dlip/harite-v2/kicad/thumbstick-breakout/README.md

Adapted from https://github.com/dbenoy/thumbstick-breakout to include a FPC connector
