dlip/harite-v2/harite-v2-bom.ods

Ordered | Name | Qty | Notes
Yes | Left PCB | 1 | Order using files in kicad/left/gerber_to_order
Yes | Right PCB | 1 | Order using files in kicad/right/gerber_to_order
Yes | Thumb cluster PCB | 2 | Order using files in kicad/thumb-cluster/gerber_to_order
Yes | Thumbstick Breakout PCB | 0-2 | Order using files in kicad/thumbstick-breakout/gerber_to_order
Yes | PMW3389 Motion Sensor | 0-2 | https://www.tindie.com/products/citizenjoe/pmw3389-motion-sensor/
y | 1/4-20 8mm OD 6mm height Knurled Insert Nut | 2 | For camera mounts https://www.aliexpress.com/item/1005005225137961.html
Yes | Smallrig clamp and ball mount | 2 | https://www.amazon.com.au/SmallRig-Ballhead-Multi-Function-Adapter-Ronin-M/dp/B08C2W7SK6/
Yes | M3 knurled insert nuts 6mm length 4.2 OD | 2 | For thumb cluster mount
y | m3*6 screws | 2 | For thumb cluster mount
y | M2 knurled insert nuts 3mm length 3.5mm OD | 36 | 24 for cases and 12 for switch caps https://www.aliexpress.com/item/1005003582355741.html
y | M2*5 screw | 12 | for switch caps
y | M2*5 screw | 8 | for base pcb
y | M2*6 screw | 16 | for thumb cluster cases
 | trackball screw?
y | 1N4148 SOD-123 Diodes | 60
y | 5 pin FFC connector Amphenol IIC 59453-051110ECHLF | 0-2 | For joystick https://www.digikey.com.au/en/products/detail/amphenol-cs-fci/59453-051110ECHLF/4272135
y | 5 pin FFC cable type-A 0.5 pitch 10cm length | 0-2 | For joystick https://www.aliexpress.com/item/1005006274471212.html
y | 8 pin FFC connector Amphenol IIC 59453-081110EDHLF | 2 | For thumb cluster https://www.digikey.com.au/en/products/detail/amphenol-cs-fci/59453-081110EDHLF/4272146
y | 8 pin FFC cable type-A 0.5 pitch 10cm length | 2 | For Thumb cluster https://www.aliexpress.com/item/1005006274471212.html
y | 12 pin FFC connector Amphenol IIC 59453-121110ECHLF | 0-2 | For Cirque Trackpad https://www.digikey.com.au/en/products/detail/amphenol-cs-fci/59453-121110ECHLF/4272151
y | 12 pin FFC cable type-A 0.5 pitch 10cm length | 0-2 | For Cirque trackpad https://www.aliexpress.com/item/1005006274471212.html
y | RP2040-Zero controller with headers 2.5mm height | 2
y | Cirque 40mm Trackpads TM040040-2024-302 flat overlay | 0-2
y | SKRHADE010 5-way switches | 12 | https://www.aliexpress.com/item/1005008022179292.html
y | ps5 hall effect joystick | 0-2 | https://www.aliexpress.com/item/1005006282848536.html
y | HRO TYPE-C-31-M-12 USB C female ports
y | USB-C to USB-C cable | 1 | To connect halves
y | USB-C to USB-A/C cable | 1 | To connect to pc
y | Super glue and toothpicks for joystick stems | 1
y | X-Ring of thickness 1.78mm and inner diameter 6.75mm | 12 | https://www.aliexpress.com/item/1005006039394059.html
y | 34mm trackball | 0-2 | https://www.amazon.com.au/Perixx-PERIPRO-303GR-Trackball-Glossy-Compatible/dp/B071NX7Y2J?th=1
y | 3mm Si3N4 static bearings | 3 per trackball | https://www.aliexpress.com/item/1005007489758993.htm
y | BTU bearings (Veichu VCN310, 7.5mm) | 3 per trackball | https://www.aliexpress.com/item/1005003066404497.html
