dlip/harite-v2/freecad/thumbstick.FCStd

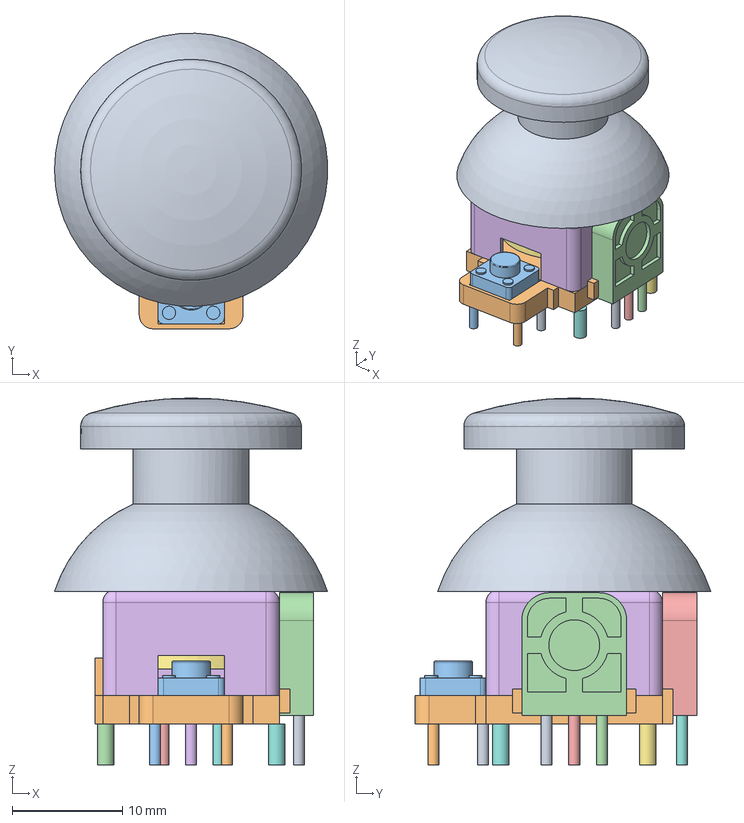
[picture p1: CAD file, 2025-01-04]
freecad/thumbstick.FCStd
24.7 x 26.8 x 33.2 mm
Thumbstick
