dlip/harite-v2/freecad/thumb-mount.FCStd

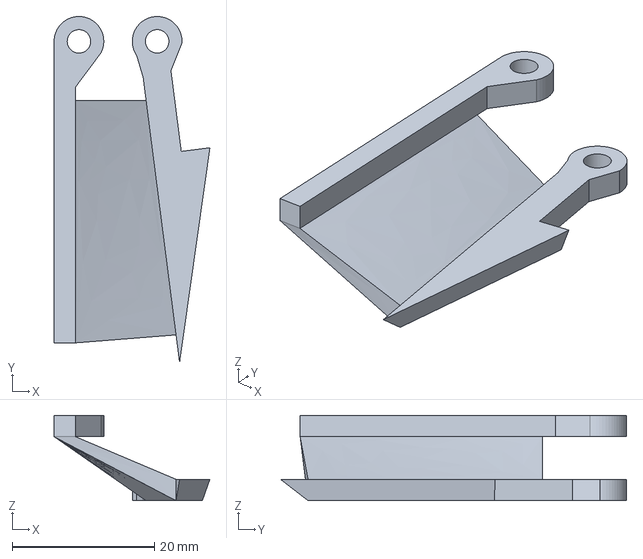
[picture p2: CAD file, 2025-01-04]
freecad/thumb-mount.FCStd
21.9 x 48.7 x 12.0 mm
