dlip/harite-v2/freecad/thumbstick-breakout.FCStd

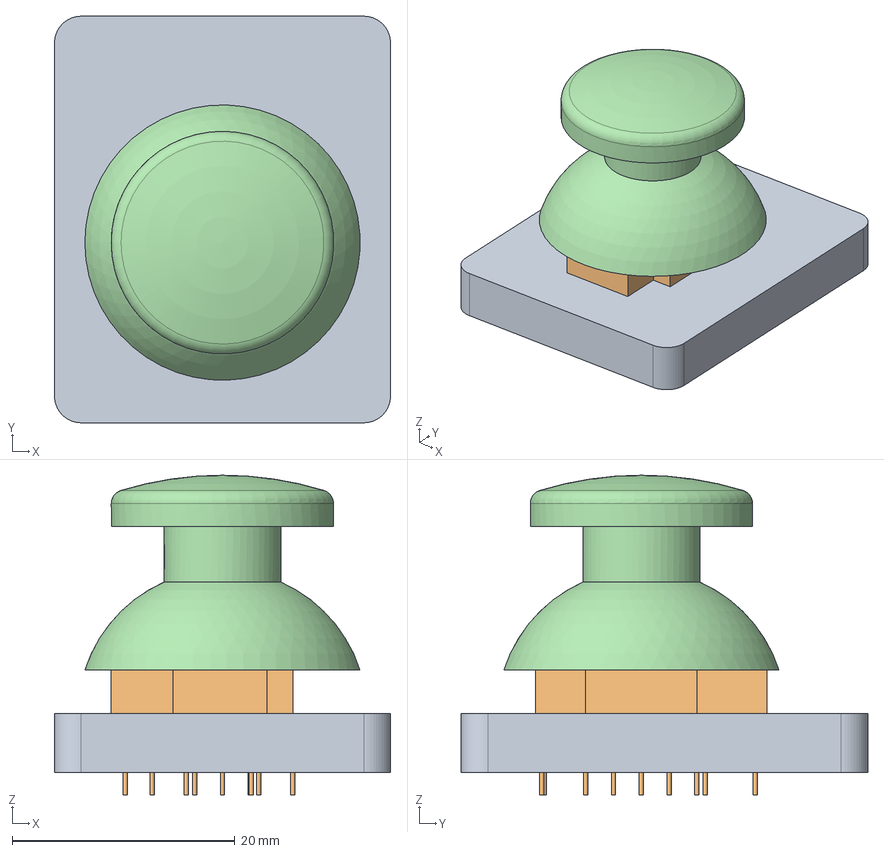
[picture p3: CAD file, 2025-01-03]
freecad/thumbstick-breakout.FCStd
30.2 x 36.5 x 28.7 mm
top
stick
Thumbstick
