dlip/harite-v2/freecad/thumbstick-breakout-orig.FCStd

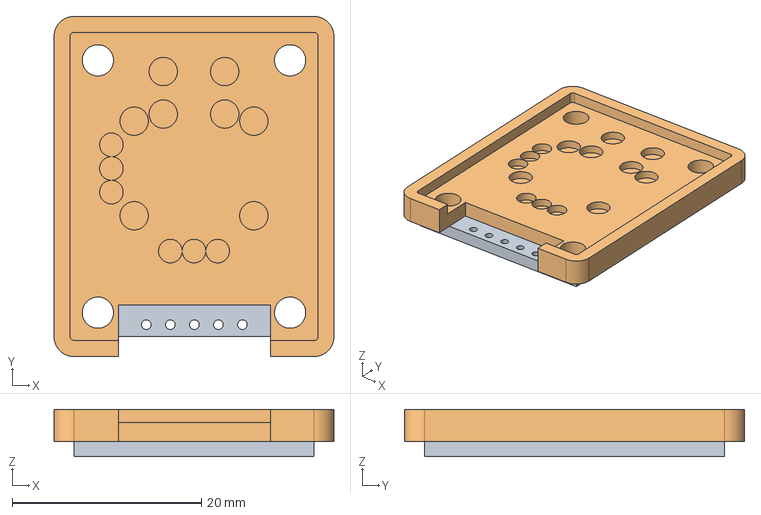
[picture p4: CAD file, 2024-12-31]
freecad/thumbstick-breakout-orig.FCStd
29.6 x 35.9 x 5.00 mm
Pcb_bbd4
base
