dlip/harite-v2/freecad/caps.FCStd

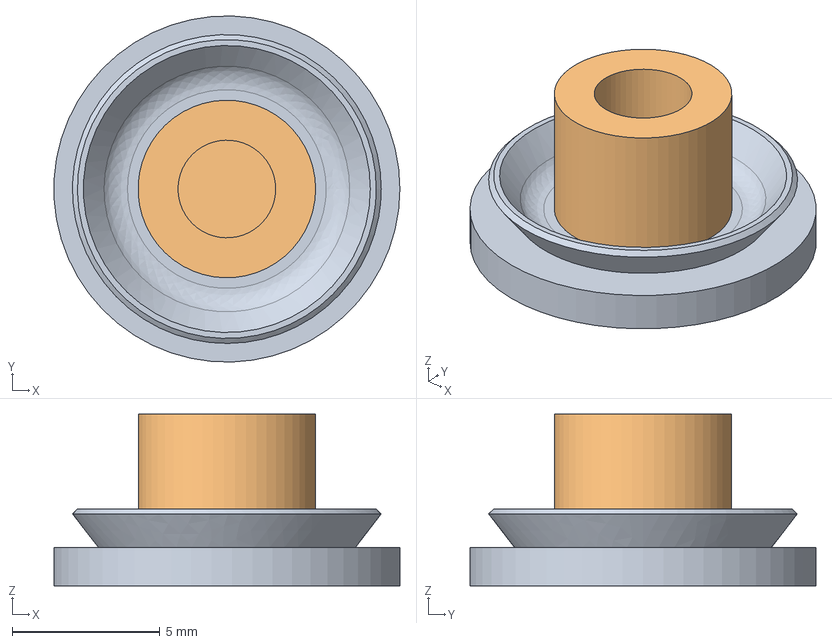
[picture p5: CAD file, 2024-12-24]
freecad/caps.FCStd
11.7 x 11.7 x 5.80 mm
xring
stem
