dlip/harite-v2/freecad/thumb-cluster.FCStd

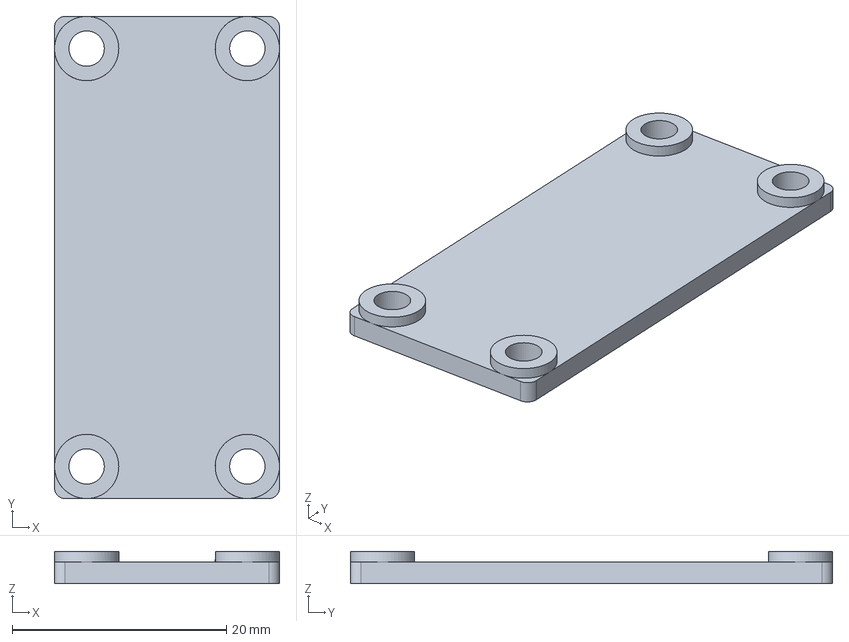
[picture p6: CAD file, 2024-12-23]
freecad/thumb-cluster.FCStd
21.0 x 45.0 x 3.00 mm
