dlip/harite-v2/freecad/case-vertical.FCStd

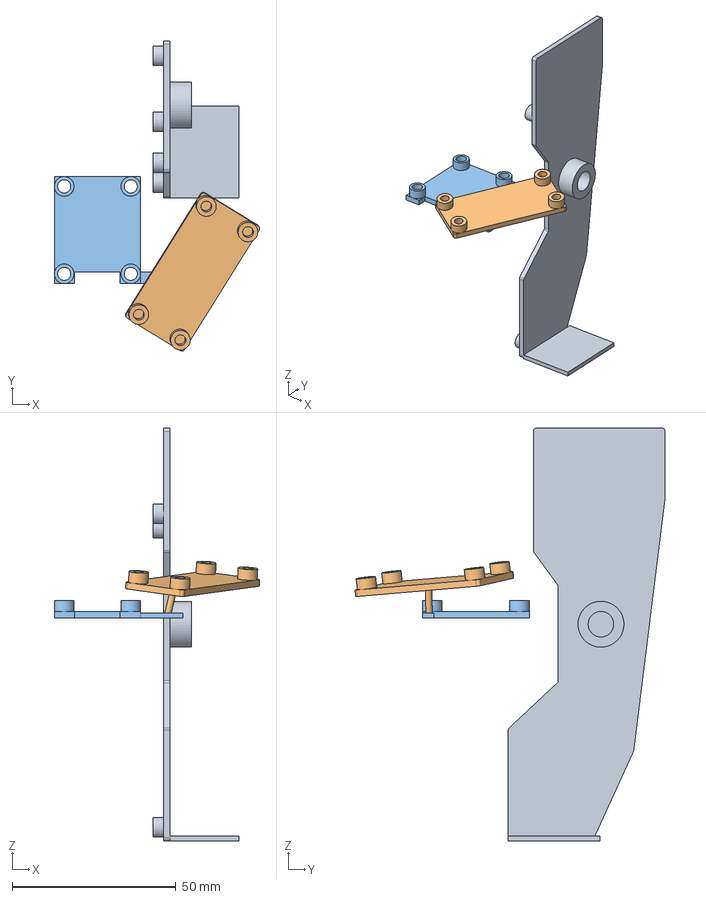
[picture p7: CAD file, 2024-12-21]
freecad/case-vertical.FCStd
62.6 x 94.6 x 126.0 mm
Left
Thumb
Thumbstick
