dlip/harite-v2/freecad/case-tented.FCStd

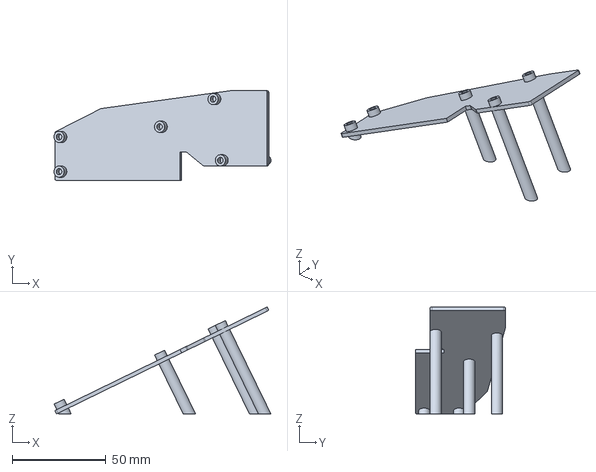
[picture p8: CAD file, 2024-12-20]
freecad/case-tented.FCStd
115.7 x 47.9 x 57.0 mm
