dlip/harite-v2/freecad/trackball-holder.FCStd

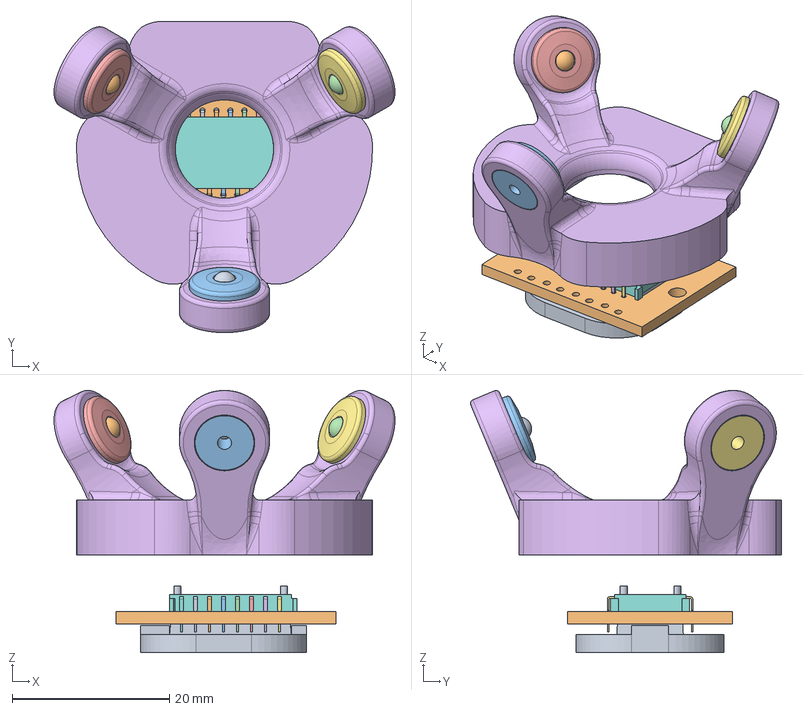
[picture p9: CAD file, 2024-12-19]
freecad/trackball-holder.FCStd
43.4 x 39.6 x 33.4 mm
Static bearing
Static bearing001
Bearing holder
Static bearing002
Bearing holder001
Trackball-holder
Bearing holder002
Lead
Lead001
Lead002
Lead003
Lead004
Lead005
Lead006
Lead007
Lead(Mirror)
Lead(Mirror)001
Lead(Mirror)002
Lead(Mirror)003
Lead(Mirror)004
Lead(Mirror)005
Lead(Mirror)006
Lead(Mirror)007
Lens
PMW3360DM PCB
