dlip/harite-v2/freecad/tindie-pmw3360.FCStd

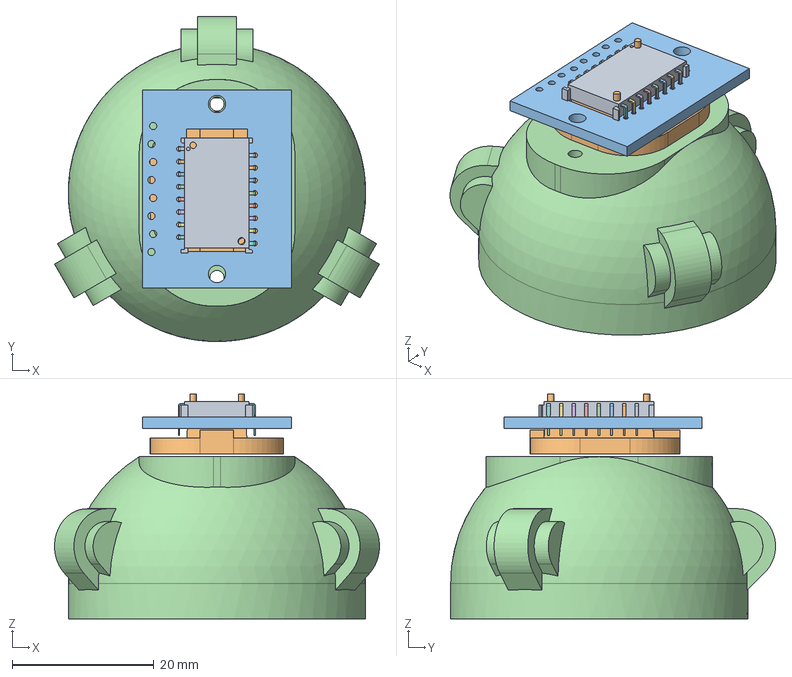
[picture p10: CAD file, 2024-12-19]
freecad/tindie-pmw3360.FCStd
45.9 x 45.9 x 31.7 mm
Lead008
Lead009
Lead010
Lead011
Lead012
Lead013
Lead014
Lead015
Lead(Mirror)008
Lead(Mirror)009
Lead(Mirror)010
Lead(Mirror)011
Lead(Mirror)012
Lead(Mirror)013
Lead(Mirror)014
Lead(Mirror)015
Lens001
PMW3360DM PCB001
Trackball_Holder
