dlip/harite-v2/freecad/case-tent.FCStd

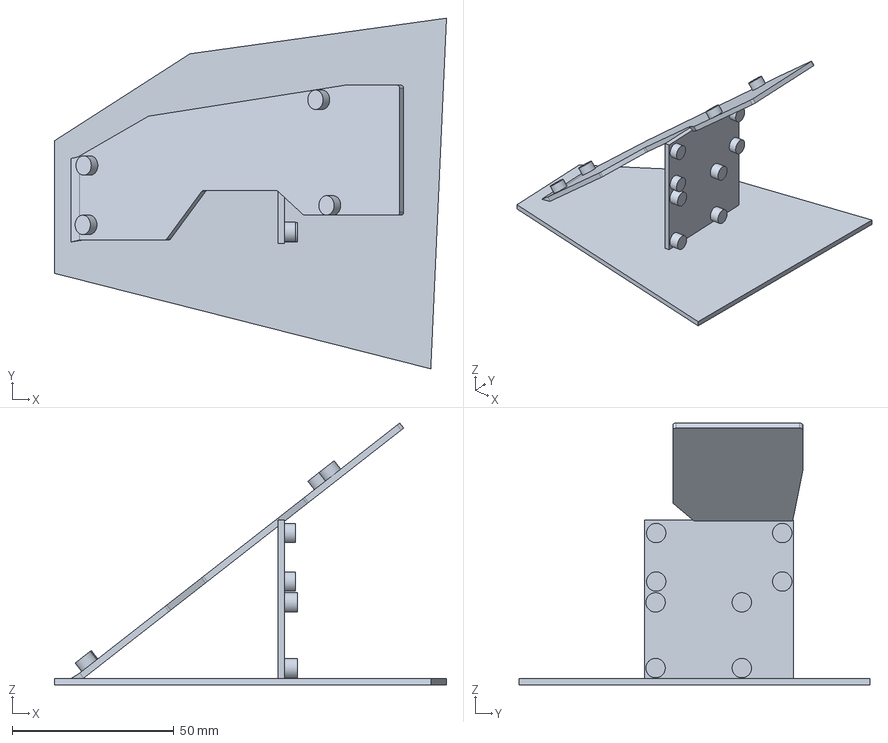
[picture p11: CAD file, 2024-12-14]
freecad/case-tent.FCStd
121.3 x 108.5 x 81.0 mm
