dlip/harite-v2/freecad/case-tent-nojoy.FCStd

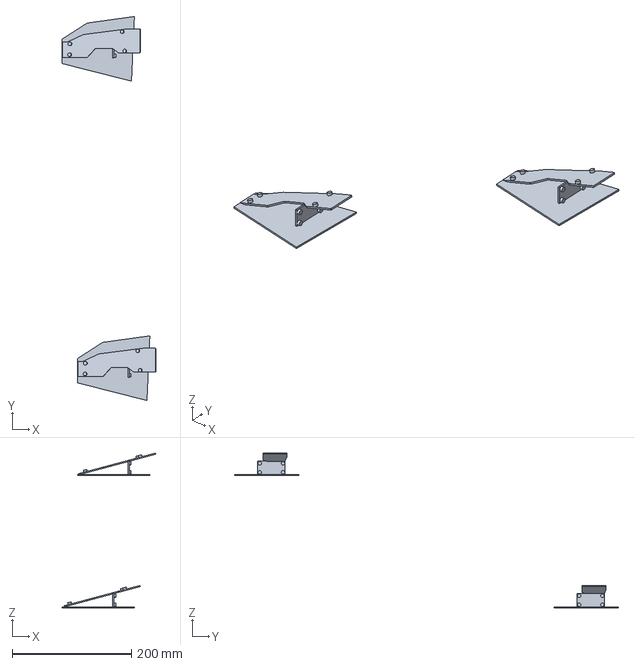
[picture p12: CAD file, 2024-12-14]
freecad/case-tent-nojoy.FCStd
157.2 x 644.2 x 259.9 mm
