dlip/harite-v2/freecad/case.FCStd

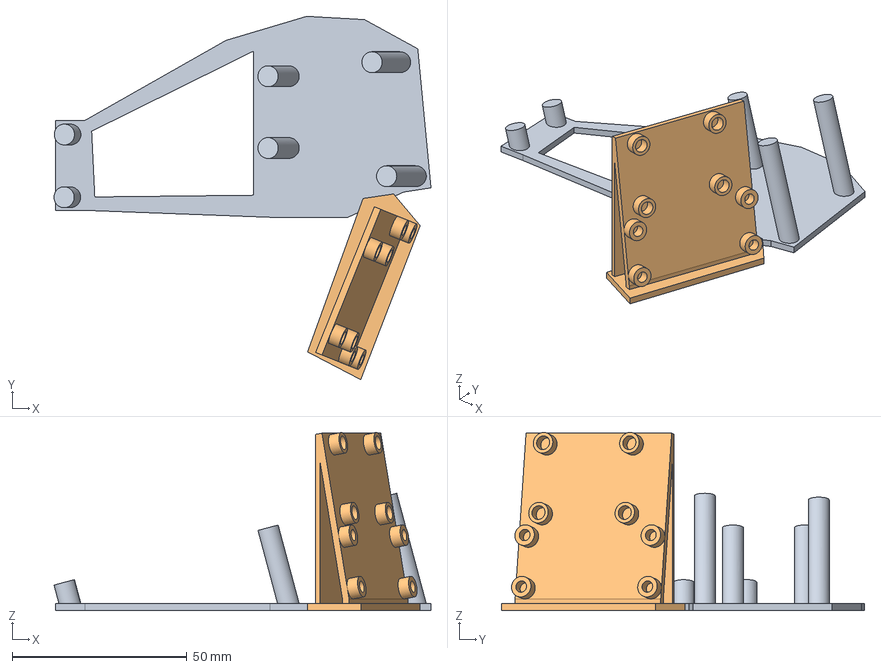
[picture p13: CAD file, 2024-12-12]
freecad/case.FCStd
108.0 x 104.1 x 51.0 mm
