dlip/harite-v2/(list of files, cad)

Other CAD files:
freecad/assemblies.FCStd
