dlip/harite-v2/kicad/left/left.kicad_pcb

## KiCad design kicad/left/left.kicad_pcb (2024-12-19)

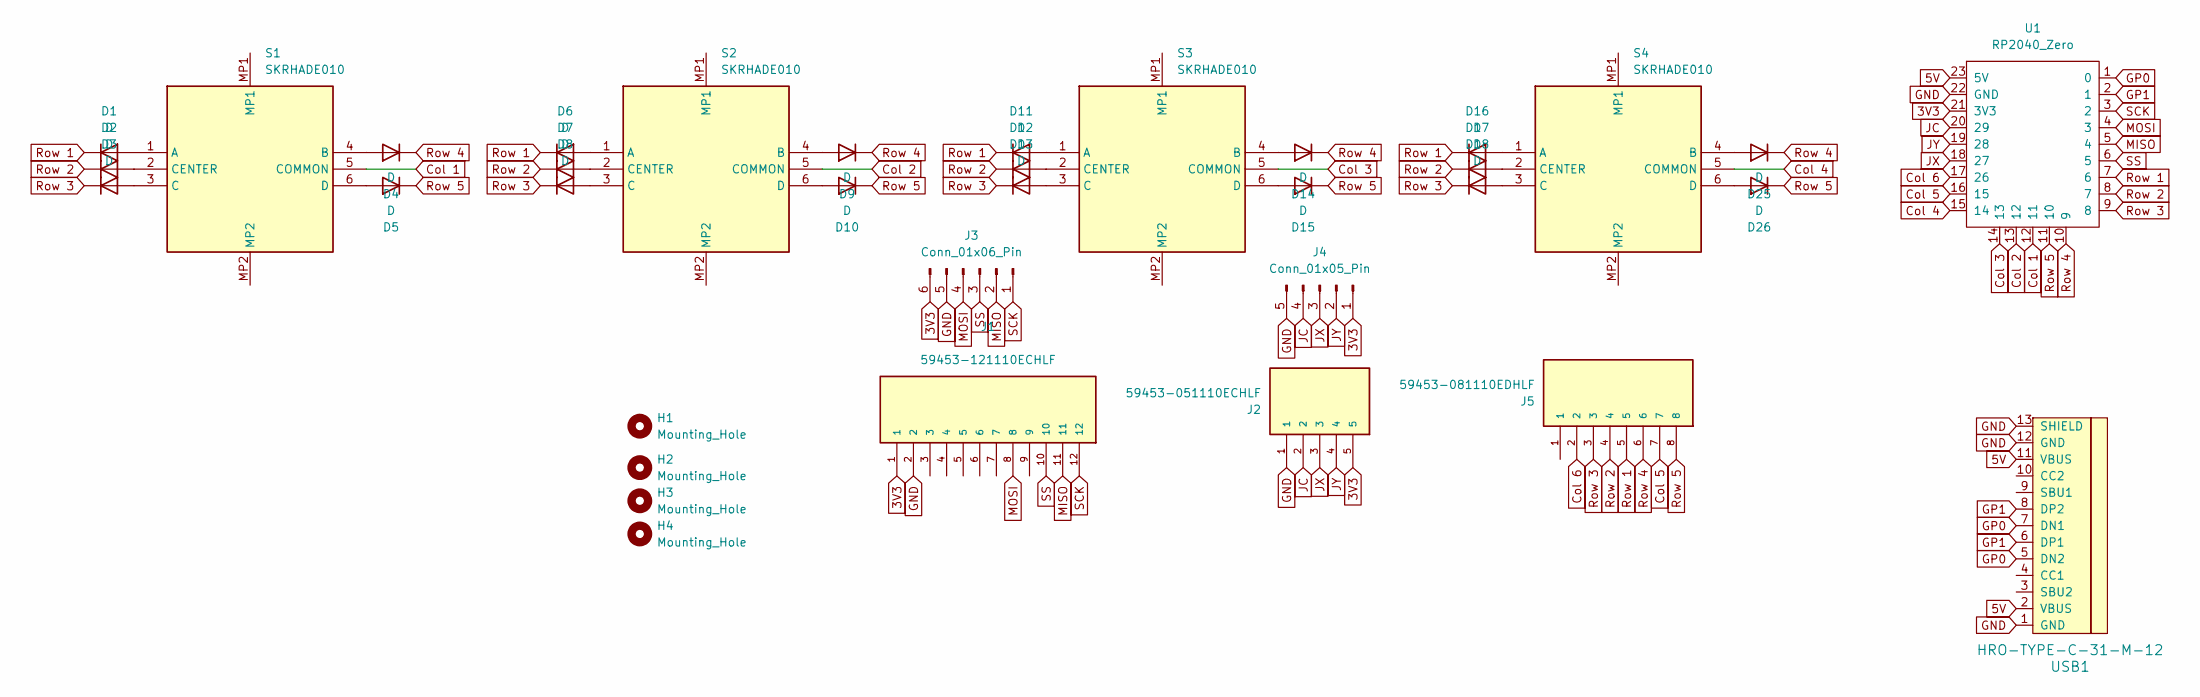
[picture p14: schematic left.kicad_sch]

Parts:
D1, D2, D3, D4, D5, D6, D7, D8, D9, D10, D11, D12, D13, D14, D15, D16, D17, D18, D25, D26: D; Diode_SOD-123
H1, H2, H3, H4: Mounting_Hole; MountingHole_2.2mm_M2_Pad_Via
J1: 59453-121110ECHLF; AMPHENOL_59453-121110ECHLF; PARTREV A
J2: 59453-051110ECHLF; AMPHENOL_59453-051110ECHLF; PARTREV A
J3: Conn_01x06_Pin; Pointing-connector
J4: Conn_01x05_Pin; Joystick-connector
J5: 59453-081110EDHLF; AMPHENOL_59453-081110EDHLF; PARTREV D
S1, S2, S3, S4: SKRHADE010; Manufacturer_Part_Number SKRHADE010; Mouser Part Number 688-SKRHAD
U1: RP2040_Zero
USB1: HRO-TYPE-C-31-M-12

Connections:
3V3: J1.1, J2.5, J3.6, J4.1, U1.21 (3V3)
5V: U1.23 (5V), USB1.2 (VBUS), USB1.11 (VBUS)
Col 1: S1.5 (COMMON), U1.12 (11)
Col 2: S2.5 (COMMON), U1.13 (12)
Col 3: S3.5 (COMMON), U1.14 (13)
Col 4: S4.5 (COMMON), U1.15 (14)
Col 5: J5.7, U1.16 (15)
Col 6: J5.2, U1.17 (26)
GND: J1.2, J2.1, J3.5, J4.5, U1.22 (GND), USB1.1 (GND), USB1.12 (GND), USB1.13 (SHIELD)
GP0: U1.1 (0), USB1.5 (DN2), USB1.7 (DN1)
GP1: U1.2 (1), USB1.6 (DP1), USB1.8 (DP2)
JC: J2.2, J4.4, U1.20 (29)
JX: J2.3, J4.3, U1.18 (27)
JY: J2.4, J4.2, U1.19 (28)
MISO: J1.11, J3.2, U1.5 (4)
MOSI: J1.8, J3.4, U1.4 (3)
unnamed: D1.2 (A), S1.1 (A)
unnamed: D2.2 (A), S1.2 (CENTER)
unnamed: D3.2 (A), S1.3 (C)
unnamed: D4.2 (A), S1.4 (B)
unnamed: D5.2 (A), S1.6 (D)
unnamed: D6.2 (A), S2.1 (A)
unnamed: D7.2 (A), S2.2 (CENTER)
unnamed: D8.2 (A), S2.3 (C)
unnamed: D9.2 (A), S2.4 (B)
unnamed: D10.2 (A), S2.6 (D)
unnamed: D11.2 (A), S3.1 (A)
unnamed: D12.2 (A), S3.2 (CENTER)
unnamed: D13.2 (A), S3.3 (C)
unnamed: D14.2 (A), S3.4 (B)
unnamed: D15.2 (A), S3.6 (D)
unnamed: D16.2 (A), S4.1 (A)
unnamed: D17.2 (A), S4.2 (CENTER)
unnamed: D18.2 (A), S4.3 (C)
unnamed: D25.2 (A), S4.4 (B)
unnamed: D26.2 (A), S4.6 (D)
Row 1: D1.1 (K), D6.1 (K), D11.1 (K), D16.1 (K), J5.5, U1.7 (6)
Row 2: D2.1 (K), D7.1 (K), D12.1 (K), D17.1 (K), J5.4, U1.8 (7)
Row 3: D3.1 (K), D8.1 (K), D13.1 (K), D18.1 (K), J5.3, U1.9 (8)
Row 4: D4.1 (K), D9.1 (K), D14.1 (K), D25.1 (K), J5.6, U1.10 (9)
Row 5: D5.1 (K), D10.1 (K), D15.1 (K), D26.1 (K), J5.8, U1.11 (10)
SCK: J1.12, J3.1, U1.3 (2)
SS: J1.10, J3.3, U1.6 (5)

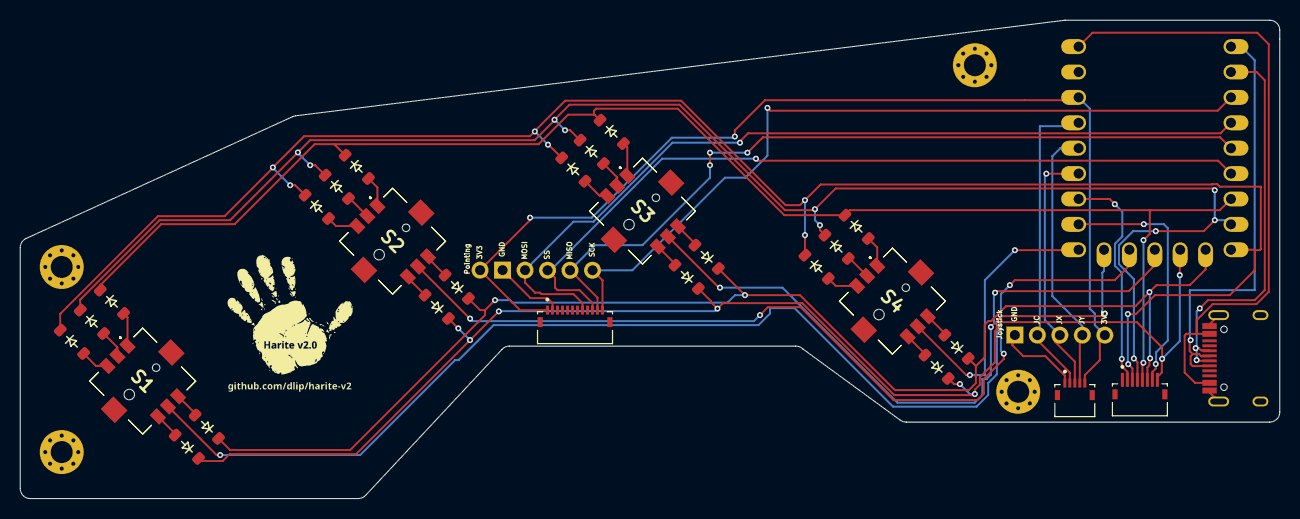
[picture p15: board left.kicad_pcb from above]

Board: 2 copper layers, 126.0 x 47.8 mm, 35 parts (0 on the bottom side), 43 nets.
