dlip/harite-v2/kicad/thumbstick-breakout/thumbstick-breakout.kicad_pcb

## KiCad design kicad/thumbstick-breakout/thumbstick-breakout.kicad_pcb (2024-12-18)

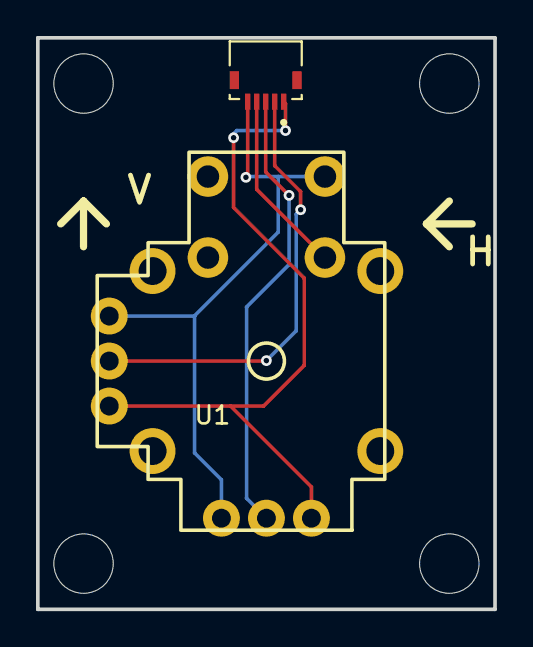
[picture p16: board thumbstick-breakout.kicad_pcb from above]

Board: 2 copper layers, 25.4 x 31.8 mm, 6 parts (0 on the bottom side), 5 nets.

Parts:
J1: 59453-051110ECHLF; AMPHENOL_59453-051110ECHLF
U1: Joystick
U$3, U$4, U$5, U$6: Screw Hole

Connections:
/HORZ: J1.3, U1.2 (H)
/SEL: J1.4, U1.a (SEL+)
/VERT: J1.2, U1.2' (V)
GND: J1.5, U1.1 (H-), U1.1' (V-), U1.c (SEL-)
VCC: J1.1, U1.3 (H+), U1.3' (V+)
