dlip/harite-v2/kicad/thumb-cluster/thumb-cluster.kicad_pcb

## KiCad design kicad/thumb-cluster/thumb-cluster.kicad_pcb (2024-12-12)

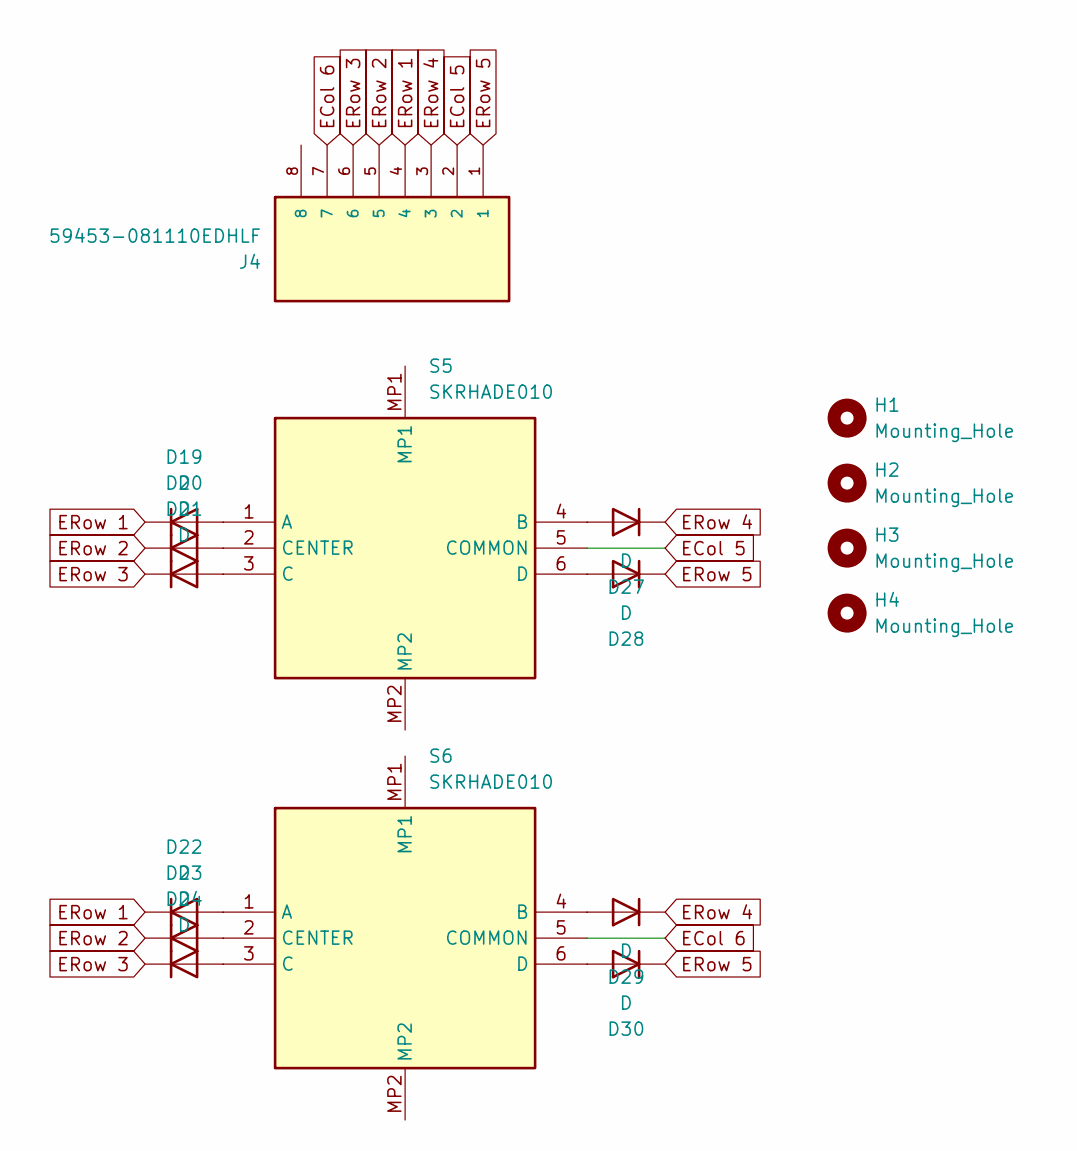
[picture p17: schematic thumb-cluster.kicad_sch]

Parts:
D19, D20, D21, D22, D23, D24, D27, D28, D29, D30: D; Diode_SOD-123
H1, H2, H3, H4: Mounting_Hole; MountingHole_2.2mm_M2_Pad_Via
J4: 59453-081110EDHLF; AMPHENOL_59453-081110EDHLF; PARTREV D
S5, S6: SKRHADE010; Manufacturer_Part_Number SKRHADE010; Mouser Part Number 688-SKRHAD

Connections:
ECol 5: J4.2, S5.5 (COMMON)
ECol 6: J4.7, S6.5 (COMMON)
ERow 1: D19.1 (K), D22.1 (K), J4.4
ERow 2: D20.1 (K), D23.1 (K), J4.5
ERow 3: D21.1 (K), D24.1 (K), J4.6
ERow 4: D27.1 (K), D29.1 (K), J4.3
ERow 5: D28.1 (K), D30.1 (K), J4.1
unnamed: D19.2 (A), S5.1 (A)
unnamed: D20.2 (A), S5.2 (CENTER)
unnamed: D21.2 (A), S5.3 (C)
unnamed: D22.2 (A), S6.1 (A)
unnamed: D23.2 (A), S6.2 (CENTER)
unnamed: D24.2 (A), S6.3 (C)
unnamed: D27.2 (A), S5.4 (B)
unnamed: D28.2 (A), S5.6 (D)
unnamed: D29.2 (A), S6.4 (B)
unnamed: D30.2 (A), S6.6 (D)

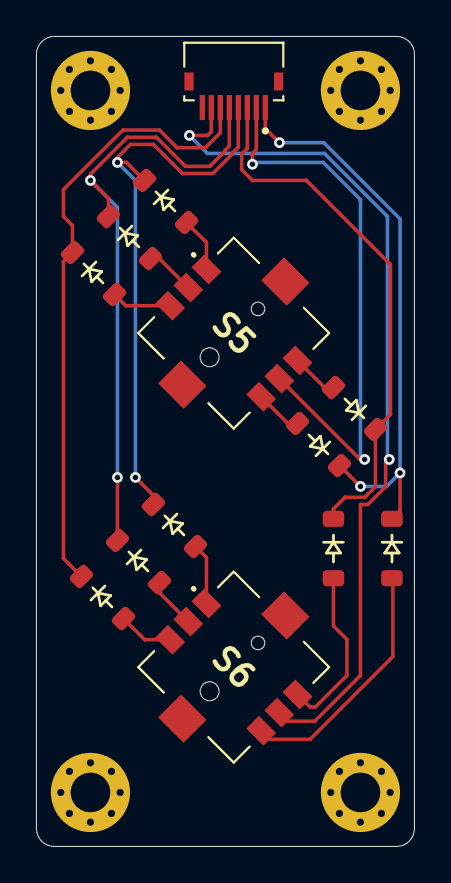
[picture p18: board thumb-cluster.kicad_pcb from above]

Board: 2 copper layers, 21.0 x 45.0 mm, 17 parts (0 on the bottom side), 17 nets.
