dlip/harite-v2/(threads)

Thread 1 (2025-01-12):

Righcasetop

RudolfVonKrugstein, 2025-01-12:
This file (https://github.com/dlip/harite-v2/blob/main/freecad/right-casetop.stl) is missing, is it not?

Thanks for the great project by the way.

dlip, 2025-01-12:
@RudolfVonKrugstein Nice catch, thanks

Closed 2025-01-12.
