dlip/harite-v2/(commit log)

2024-11-28 Add project
    [harite.kicad_sch]
2024-11-28 move kicad
    [harite.kicad_sch]
2024-12-04 break up parts
    [harite.kicad_pcb, joystick.kicad_pcb, joystick.kicad_sch, left.kicad_pcb, left.kicad_sch, thumb-cluster.kicad_pcb, thumb-cluster.kicad_sch]
2024-12-05 Freecad xring
    [cap-xring-Body.stl, cap-xring.FCStd]
2024-12-06 Freecad pcb
    [cap-xring.FCStd, harite-brd.dxf, harite-cap-xring.stl, harite.FCStd, left-brd.dxf, left.kicad_pcb, thumb-cluster-brd.dxf, thumbstick-brd.dxf]
2024-12-08 Create base
    [harite.FCStd]
2024-12-08 Add thumb cluster
    [harite.FCStd, thumb-cluster.FCStd, thumb-cluster.kicad_pcb]
2024-12-11 Add connectors
    [left.kicad_pcb, left.kicad_sch]
2024-12-11 Rename caps
    [caps.FCStd]
2024-12-11 Update footprints
    [left.kicad_pcb, left.kicad_sch]
2024-12-11 reimport files
    [caps-xring.stl, case.FCStd, harite-cap-xring.stl, harite.FCStd, left.kicad_pcb, thumb-cluster.FCStd, thumb-cluster.kicad_pcb]
2024-12-11 Add joystick breakout
    [left.kicad_pcb, left.kicad_sch, thumbstick-breakout.kicad_pcb, thumbstick-breakout.kicad_sch, thumbstick.kicad_pcb]
2024-12-11 update freecad
    [left.kicad_pcb, thumbstick-breakout.FCStd, thumbstick-breakout.kicad_pcb]
2024-12-12 extend breakout
    [thumbstick-breakout.FCStd, thumbstick-breakout.kicad_pcb]
2024-12-12 Add stem
    [cap-xring-Body.stl, caps.FCStd]
2024-12-12 Add tent
    [assemblies.FCStd, case-Part.stl, case.FCStd, thumbstick-breakout.FCStd]
2024-12-12 update thumb cluster
    [thumb-cluster.FCStd, thumb-cluster.kicad_pcb, thumb-cluster.kicad_sch]
2024-12-14 Add holes
    [case-tent-PartBody.stl, case-tent-nojoy.FCStd, case-tent.FCStd, left.kicad_pcb, left.kicad_sch]
2024-12-14 Add vertical case
    [caps.FCStd, case-vertical.FCStd, thumbstick-breakout.FCStd]
2024-12-15 thumb pos
    [caps.FCStd, case-vertical.FCStd, thumbstick-breakout.FCStd, thumbstick.FCStd]
2024-12-15 thumb 2
    [case-vertical.FCStd]
2024-12-15 trackball holder
    [case-vertical.FCStd, trackball-holder.FCStd]
2024-12-16 thumb 3
    [case-vertical.FCStd, trackball-holder.FCStd]
2024-12-18 Use only fcc on thumbstick
    [thumbstick-breakout.kicad_pcb, thumbstick-breakout.kicad_sch]
2024-12-18 Update thumbstick
    [case-vertical.FCStd, thumbstick-breakout.FCStd]
2024-12-18 Add right
    [right.kicad_pcb, right.kicad_sch]
2024-12-18 place right components
    [right.kicad_pcb]
2024-12-18 wire right
    [right.kicad_pcb]
2024-12-19 Add gerbers
    [left.kicad_pcb, right.kicad_pcb]
2024-12-19 Add tindie
    [case-vertical.FCStd, tindie-pmw3360.FCStd]
2024-12-19 Add bom and camera mount
    [case-vertical.FCStd, harite-v2-bom.ods, thumbstick.FCStd, tindie-pmw3360.FCStd, trackball-holder.FCStd]
2024-12-19 Another case
    [caps.FCStd, case-tented.FCStd, case-vertical.FCStd, harite-v2-bom.ods, thumbstick-breakout.FCStd, thumbstick.FCStd, tindie-pmw3360.FCStd, trackball-holder.FCStd]
2024-12-20 simple case
    [case-simple.FCStd, case-tented.FCStd]
2024-12-20 Base with top
    [assemblies.FCStd, caps.FCStd, case-simple.FCStd, case-tented.FCStd, case-vertical.FCStd, thumb-cluster.FCStd, thumbstick-breakout.FCStd]
2024-12-21 top and bottom
    [assemblies.FCStd, case-simple.FCStd, case-vertical.FCStd]
2024-12-21 add thumbstick
    [thumbstick-breakout.FCStd]
2024-12-23 contained thumbstick
    [assemblies.FCStd, thumbstick-breakout.FCStd, thumbstick.FCStd]
2024-12-24 tall box
    [assemblies.FCStd, caps.FCStd, thumbstick-breakout.FCStd]
2025-01-01 increase thumb cluster tolerance
    [thumb-mount.FCStd]
2025-01-02 horizontal mount
    [thumb-mount.FCStd]
2025-01-03 add support
    [thumb-mount.FCStd, thumbstick-breakout.FCStd]
2025-01-03 thicken mount connection
    [thumb-mount.FCStd]
2025-01-03 fix top
    [thumb-mount.FCStd, thumbstick-breakout.FCStd]
2025-01-03 flatten mount
    [thumb-mount.FCStd, thumbstick-breakout.FCStd]
