dlip/harite-v2/(notices)

Notices in the files:
kicad/thumbstick-breakout/thumbstick-breakout.kicad_pcb:
https://creativecommons.org/licenses/by-sa/4.0
This hardware is licensed under Creative Commons ShareAlike 4.0 International
